cctweaker/ESPbutton/Hardware/Schematic_ESPbutton_v1.1.png

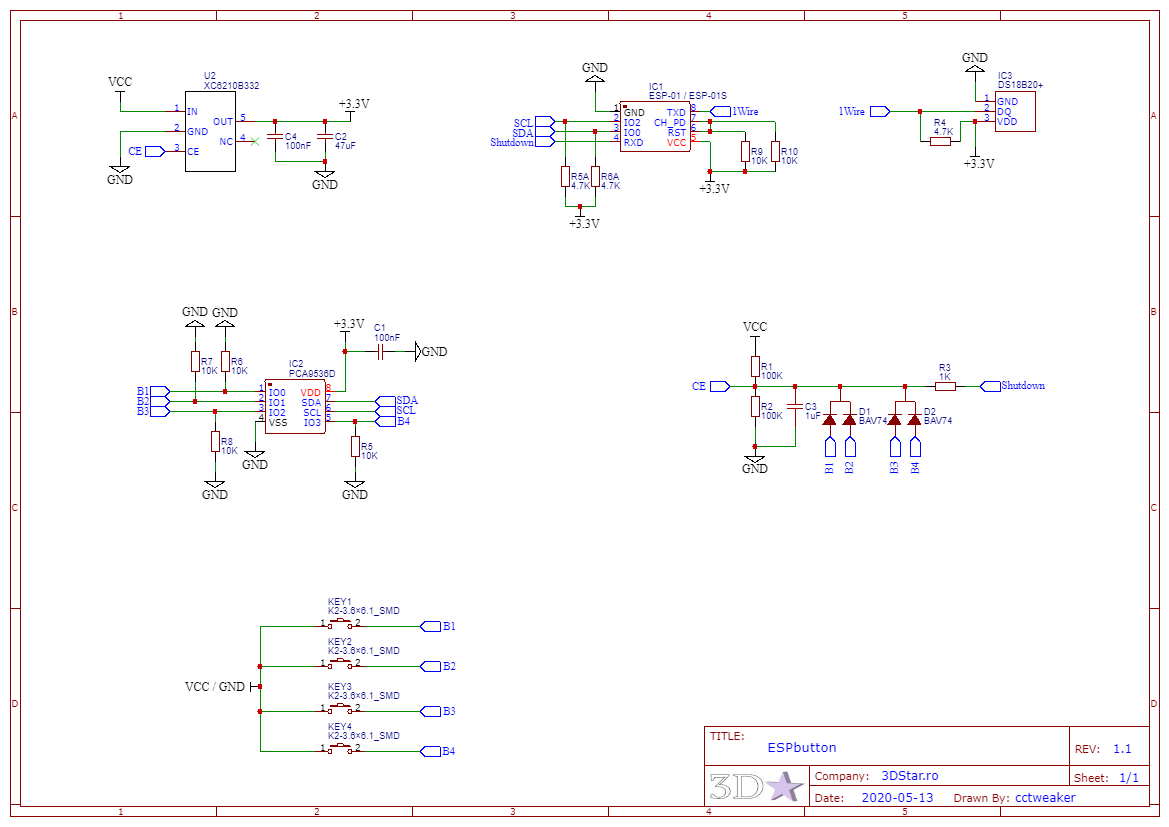
Hardware/Schematic_ESPbutton_v1.1.png
