cctweaker/ESPbutton/Hardware/Schematic_ESPbutton_v1.1.pdf

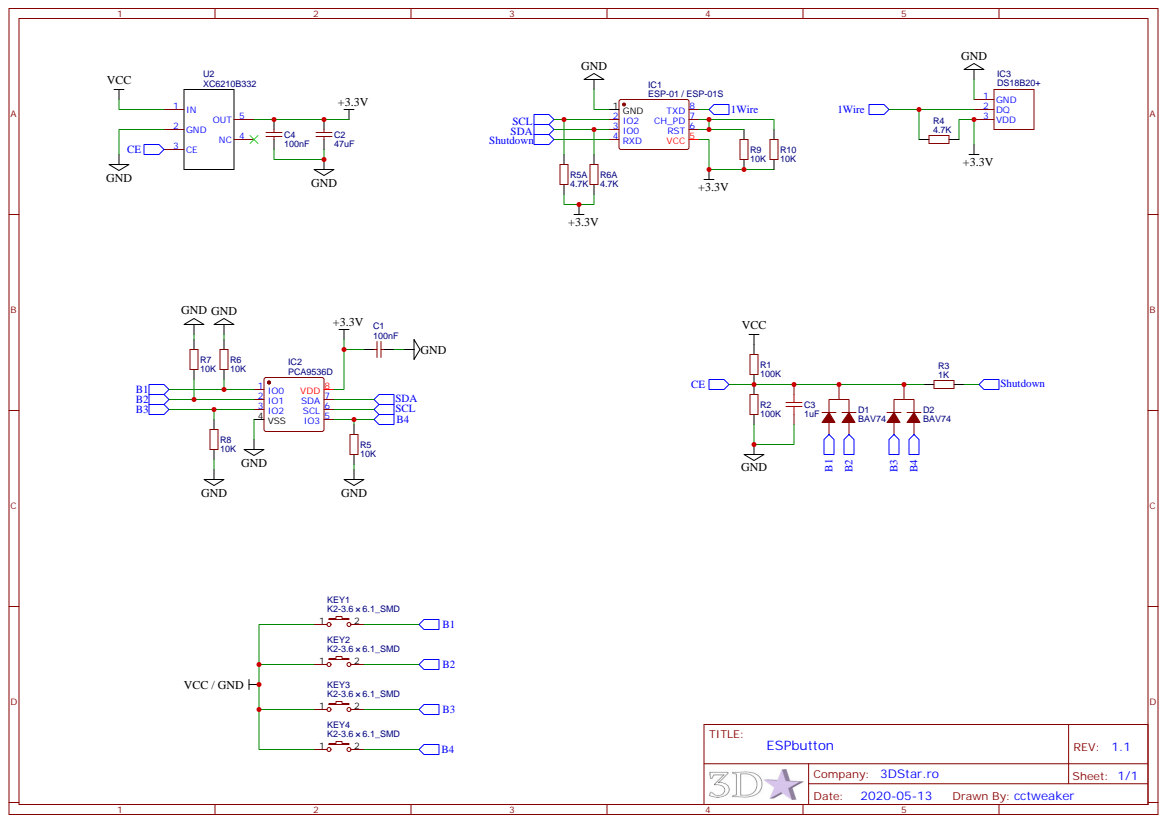
[picture p5: page 1]
